Luk13g/ABM_DataGlove/Imagens/Img_02.jpg

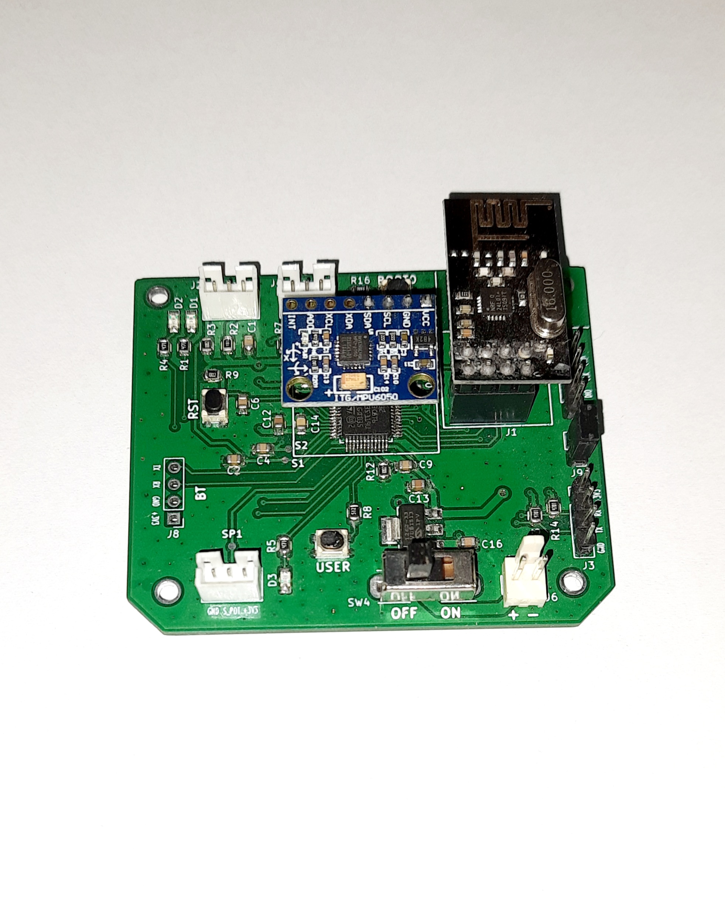
Imagens/Img_02.jpg
