Luk13g/ABM_DataGlove/Imagens/Img_01.jpg

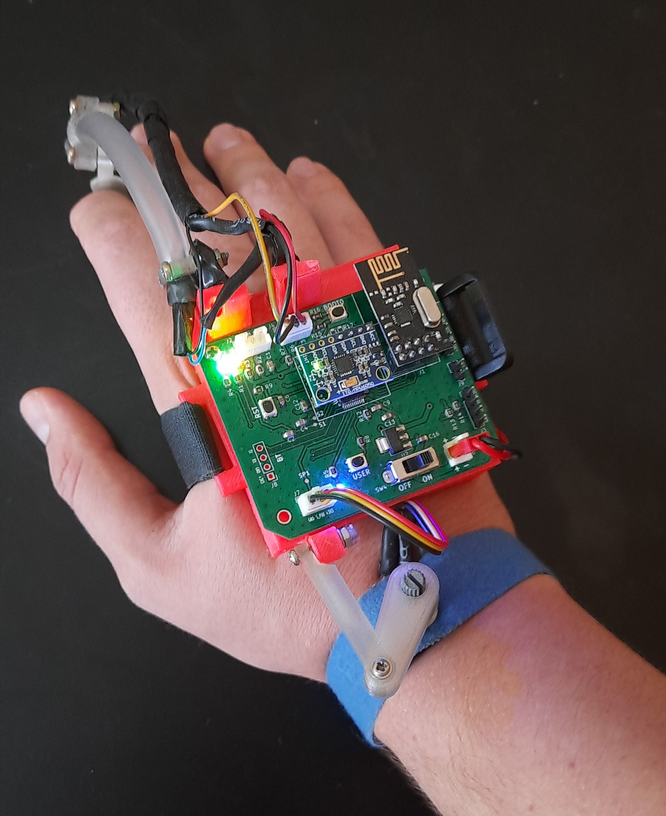
Imagens/Img_01.jpg
