Luk13g/ABM_DataGlove/README.md

# ABM_DataGlove
Data Glove for robotic hand-forearm teleoperation systems applications
