Luk13g/ABM_DataGlove/3d_parts/full_model.3mf

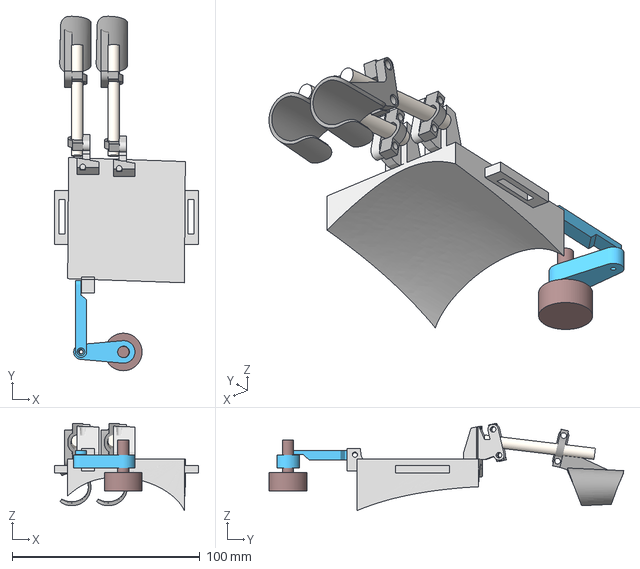
[picture p3: CAD file, 2022-12-28]
3d_parts/full_model.3mf
76.7 x 188.8 x 46.5 mm
