Luk13g/ABM_DataGlove/3d_parts/bracelet_fixation_potentiometer.stl

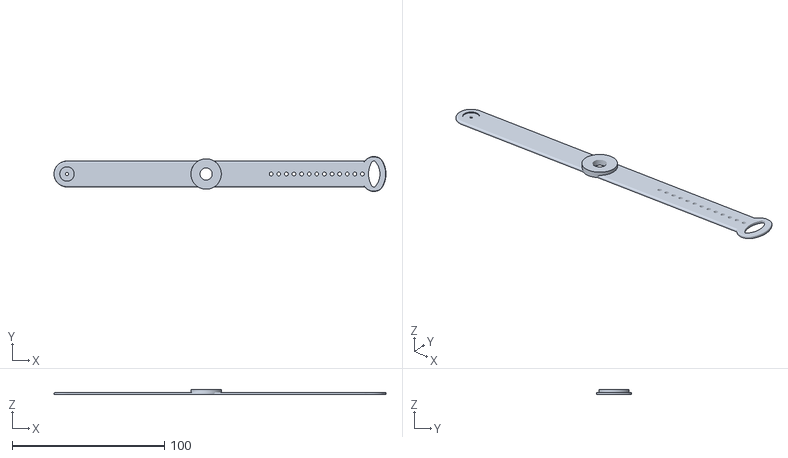
[picture p4: CAD file, 2022-12-28]
3d_parts/bracelet_fixation_potentiometer.stl
218.3 x 23.0 x 3.50
