Luk13g/ABM_DataGlove/3d_parts/base.stl

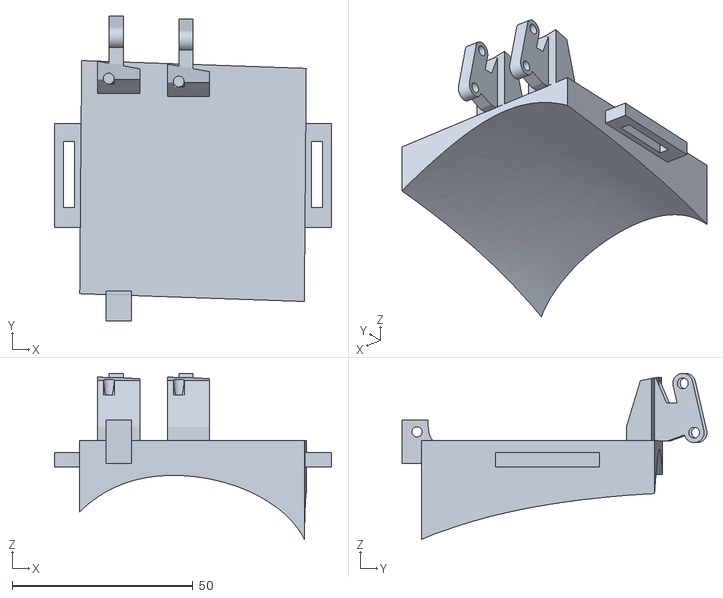
[picture p5: CAD file, 2022-12-28]
3d_parts/base.stl
76.7 x 84.4 x 46.0
