Luk13g/ABM_DataGlove/3d_parts/handle_support_finger_sensor.stl

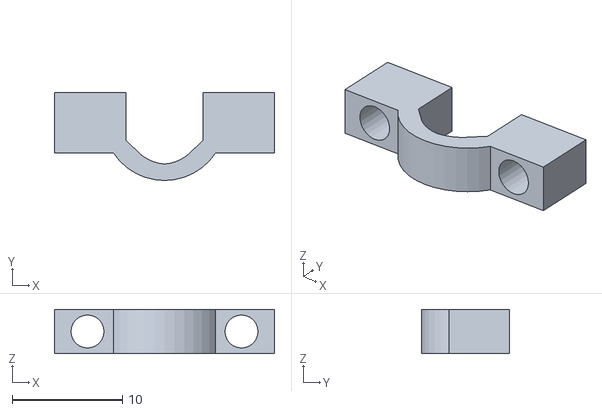
[picture p6: CAD file, 2022-12-28]
3d_parts/handle_support_finger_sensor.stl
20.0 x 8.00 x 4.00
