Luk13g/ABM_DataGlove/3d_parts/base_potentiometer.stl

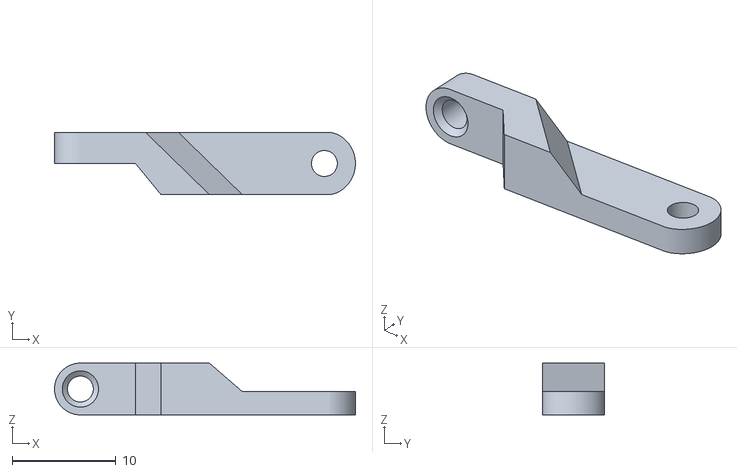
[picture p7: CAD file, 2022-12-28]
3d_parts/base_potentiometer.stl
29.0 x 6.00 x 5.00
