Luk13g/ABM_DataGlove/3d_parts/finger_suport.stl

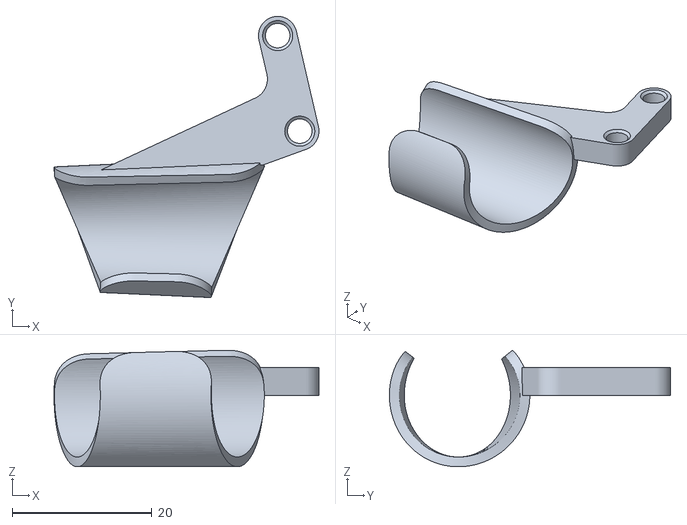
[picture p8: CAD file, 2022-12-28]
3d_parts/finger_suport.stl
37.9 x 40.2 x 16.7
