Luk13g/ABM_DataGlove/3d_parts/potentiometer_part.stl

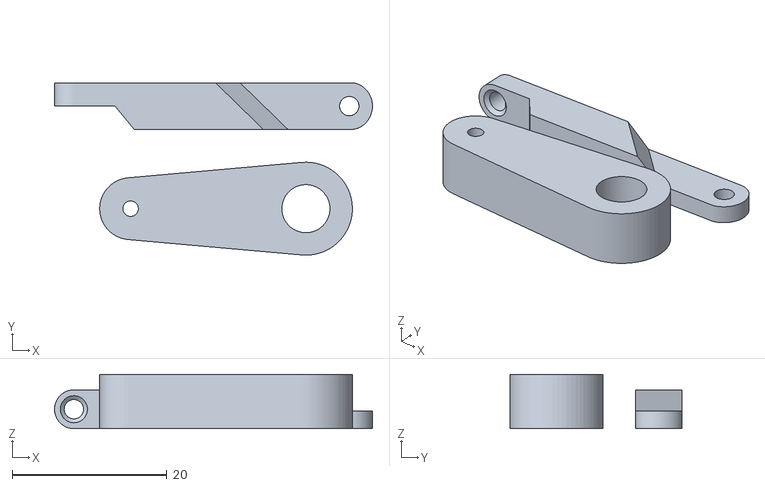
[picture p9: CAD file, 2022-12-28]
3d_parts/potentiometer_part.stl
41.0 x 22.2 x 7.00
