Luk13g/ABM_DataGlove/Hardware/v1.0/arm_control_PCB.kicad_pcb

## KiCad design Hardware/v1.0/arm_control_PCB.kicad_pcb (2022-12-28)

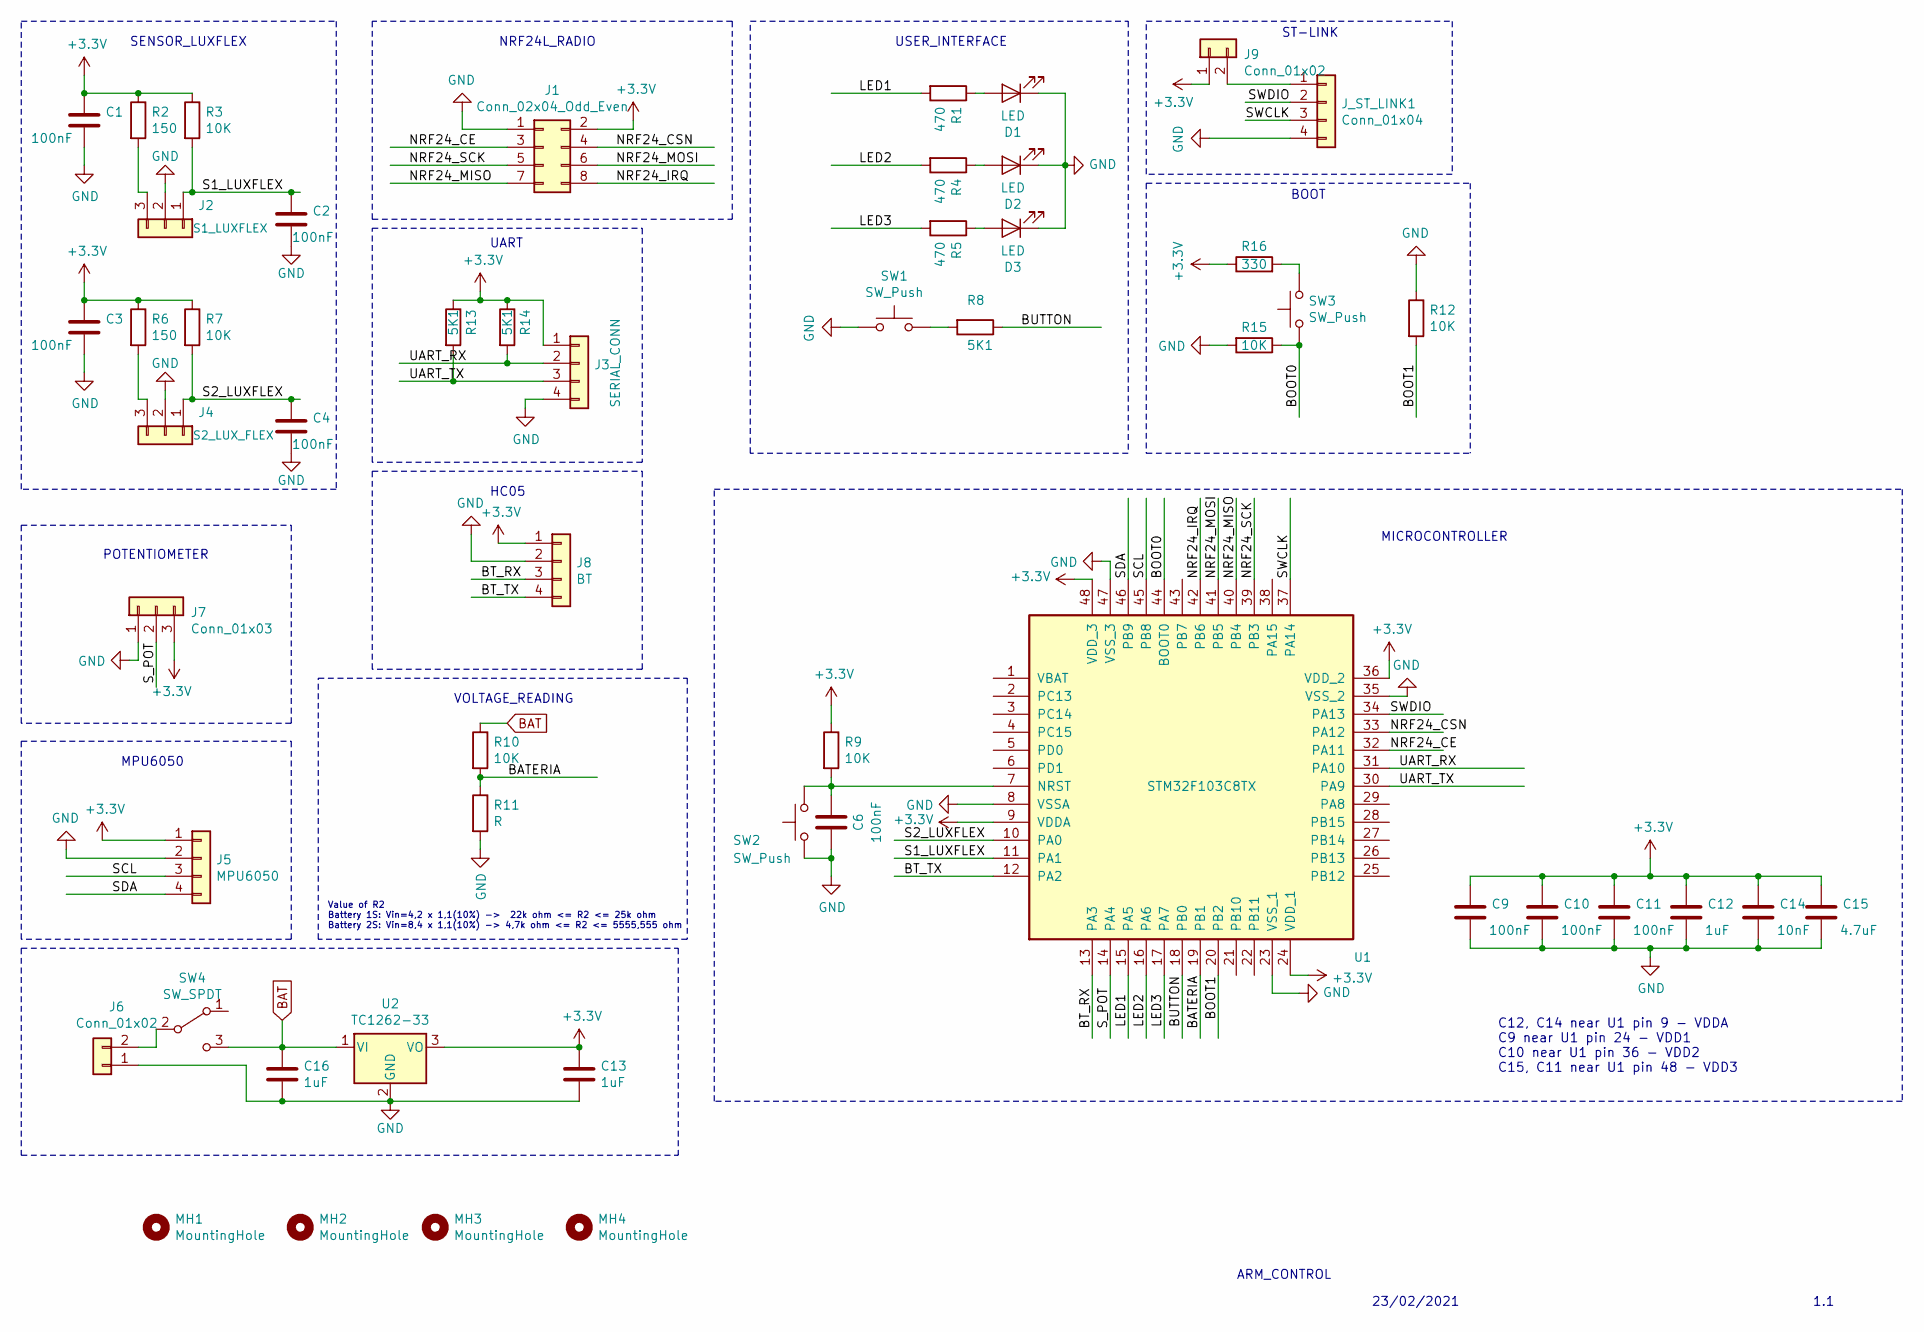
[picture p10: schematic arm_control_PCB.sch, ARM_Control]

Parts:
C1, C2, C3, C4, C6, C9, C10, C11: 100nF; C_0805
C12, C13: 1uF; C_0805
C14: 10nF; C_0805
C15: 4.7uF; C_0805
C16: 1uF; C_0805_2012Metric
D1, D2, D3: LED; LED_0805
J1: Conn_02x04_Odd_Even; Socket_Strip_Straight_2x04_Pitch2.54mm
J2: S1_LUXFLEX; JST_PH_B3B-PH-K_03x2.00mm_Straight
J3: SERIAL_CONN; Socket_Strip_Straight_1x04_Pitch2.54mm
J4: S2_LUX_FLEX; JST_PH_B3B-PH-K_03x2.00mm_Straight
J5: MPU6050; Socket_Strip_Straight_1x04_Pitch2.54mm
J6, J9: Conn_01x02; Pin_Header_Straight_1x02_Pitch2.54mm
J7: Conn_01x03; JST_PH_B3B-PH-K_03x2.00mm_Straight
J8: BT; Socket_Strip_Straight_1x04_Pitch2.54mm
J_ST_LINK1: Conn_01x04; Pin_Header_Straight_1x04_Pitch2.54mm
MH1, MH2, MH3, MH4: MountingHole; SolderWirePad_single_1-2mmDrill
R1, R4, R5: 470; R_0805
R2, R6: 150; R_0805
R3, R7, R9, R10, R12, R15: 10K; R_0805
R8, R13, R14: 5K1; R_0805
R11: R; R_0805
R16: 330; R_0805
SW1, SW2, SW3: SW_Push; SW_SPST_PTS810
SW4: SW_SPDT; SW_SS12F23G6_Angled
U1: STM32F103C8TX; LQFP-48_7x7mm_Pitch0.5mm
U2: TC1262-33; SOT-223-3_TabPin2

Connections:
+3V3: C1.1, C3.1, C9.1, C10.1, C11.1, C12.1, C13.1, C14.1, C15.1, J1.2, J3.1, J5.1, J7.3, J8.1, J9.1, R2.1, R3.1, R6.1, R7.1, R9.1, R13.1, R14.1, R16.1, U1.9 (VDDA), U1.24 (VDD_1), U1.36 (VDD_2), U1.48 (VDD_3), U2.3 (VO)
/BATERIA: R10.2, R11.1, U1.19 (PB1)
/BOOT0: R15.1, SW3.1, U1.44 (BOOT0); also elsewhere on the board
/BOOT1: R12.2, U1.20 (PB2)
/BT_RX: J8.3, U1.13 (PA3)
/BT_TX: J8.4, U1.12 (PA2)
/BUTTON: R8.1, U1.18 (PB0)
/LED1: R1.2, U1.15 (PA5)
/LED2: R4.2, U1.16 (PA6)
/LED3: R5.2, U1.17 (PA7)
/NRF24_CE: J1.3, U1.32 (PA11)
/NRF24_CSN: J1.4, U1.33 (PA12)
/NRF24_IRQ: J1.8, U1.42 (PB6)
/NRF24_MISO: J1.7, U1.40 (PB4)
/NRF24_MOSI: J1.6, U1.41 (PB5)
/NRF24_SCK: J1.5, U1.39 (PB3)
/S1_LUXFLEX: C2.1, J2.1, R3.2, U1.11 (PA1)
/S2_LUXFLEX: C4.1, J4.1, R7.2, U1.10 (PA0)
/SCL: J5.3, U1.45 (PB8)
/SDA: J5.4, U1.46 (PB9)
/SWCLK: J_ST_LINK1.3, U1.37 (PA14); also elsewhere on the board
/SWDIO: J_ST_LINK1.2, U1.34 (PA13); also elsewhere on the board
/S_POT: J7.2, U1.14 (PA4)
/UART_RX: J3.2, R14.2, U1.31 (PA10)
/UART_TX: J3.3, R13.2, U1.30 (PA9)
BAT: C16.1, R10.1, SW4.3 (C), U2.1 (VI)
GND: C1.2, C2.2, C3.2, C4.2, C6.2, C9.2, C10.2, C11.2, C12.2, C13.2, C14.2, C15.2, C16.2, D1.1 (K), D2.1 (K), D3.1 (K), J1.1, J2.2, J3.4, J4.2, J5.2, J6.1, J7.1, J8.2, J_ST_LINK1.4, R11.2, R12.1, R15.2, SW1.1, SW2.1, U1.8 (VSSA), U1.23 (VSS_1), U1.35 (VSS_2), U1.47 (VSS_3), U2.2 (GND); also elsewhere on the board
unnamed 27: C6.1, R9.2, SW2.2, U1.7 (NRST); also elsewhere on the board
unnamed: D1.2 (A), R1.1
unnamed: D2.2 (A), R4.1
unnamed: D3.2 (A), R5.1
unnamed: J2.3, R2.2
unnamed: J4.3, R6.2
unnamed: J6.2, SW4.2 (B)
unnamed 34: J9.2, J_ST_LINK1.1; also elsewhere on the board
unnamed 35: R8.2, SW1.2; also elsewhere on the board
unnamed 36: R16.2, SW3.2; also elsewhere on the board

Notes on the sheet:
MPU6050
UART
NRF24L_RADIO
SENSOR_LUXFLEX
USER_INTERFACE
POTENTIOMETER
HC05
VOLTAGE_READING
ST-LINK
MICROCONTROLLER
C12, C14 near U1 pin 9 - VDDA C9 near U1 pin 24 - VDD1 C10 near U1 pin 36 - VDD2 C15, C11 near U1 pin 48 - VDD3
BOOT
Value of R2 Battery 1S: Vin=4,2 x 1,1(10%) -> 22k ohm <= R2 <= 25k ohm Battery 2S: Vin=8,4 x 1,1(10%) -> 4,7k ohm <= R2 <= 5555,555 ohm
ARM_CONTROL
23/02/2021
1.1

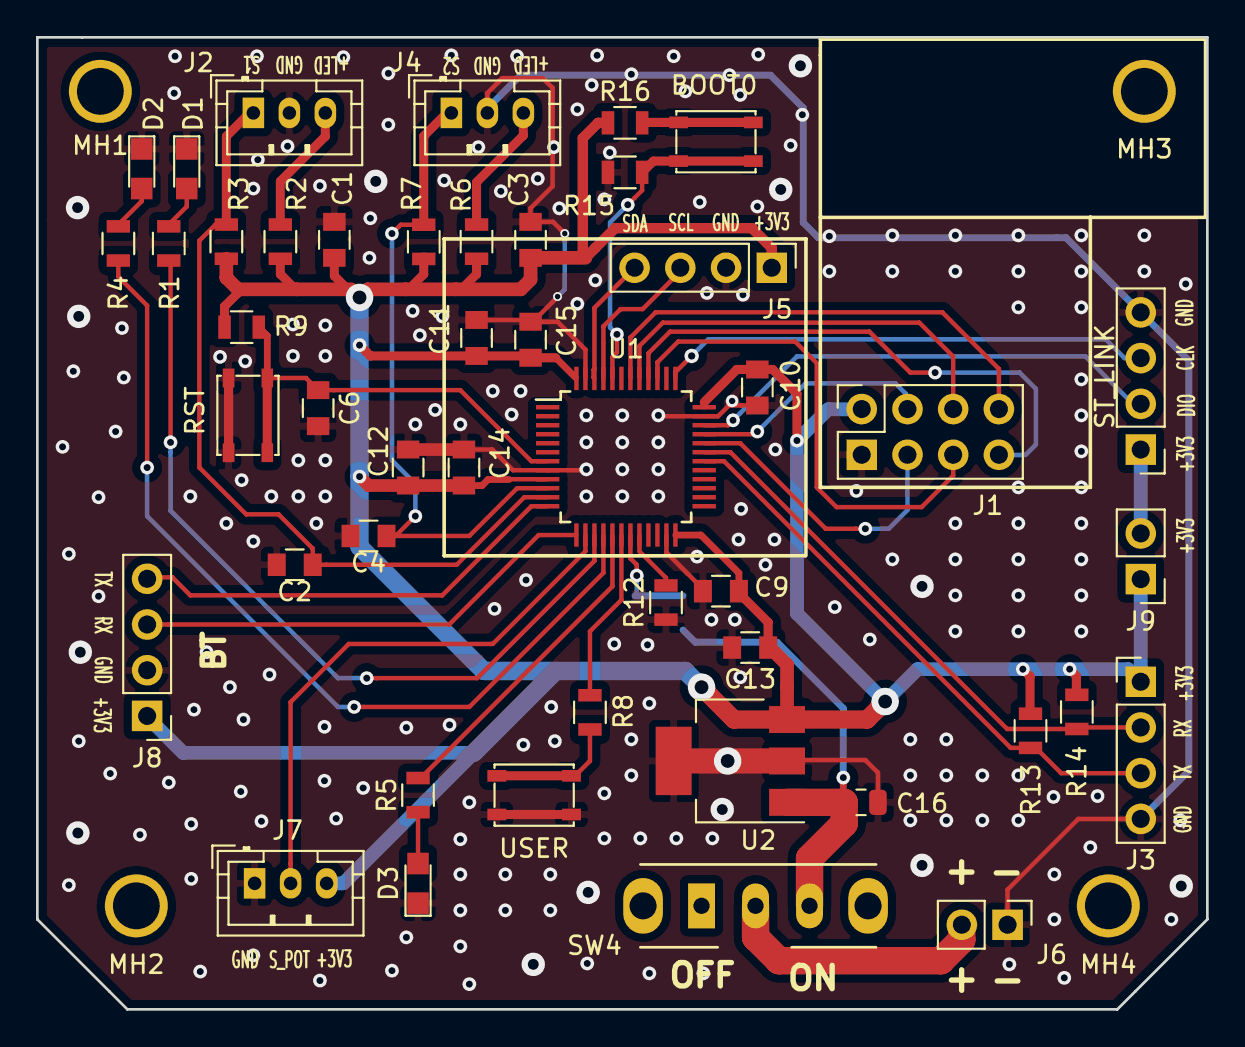
[picture p11: board arm_control_PCB.kicad_pcb from above]

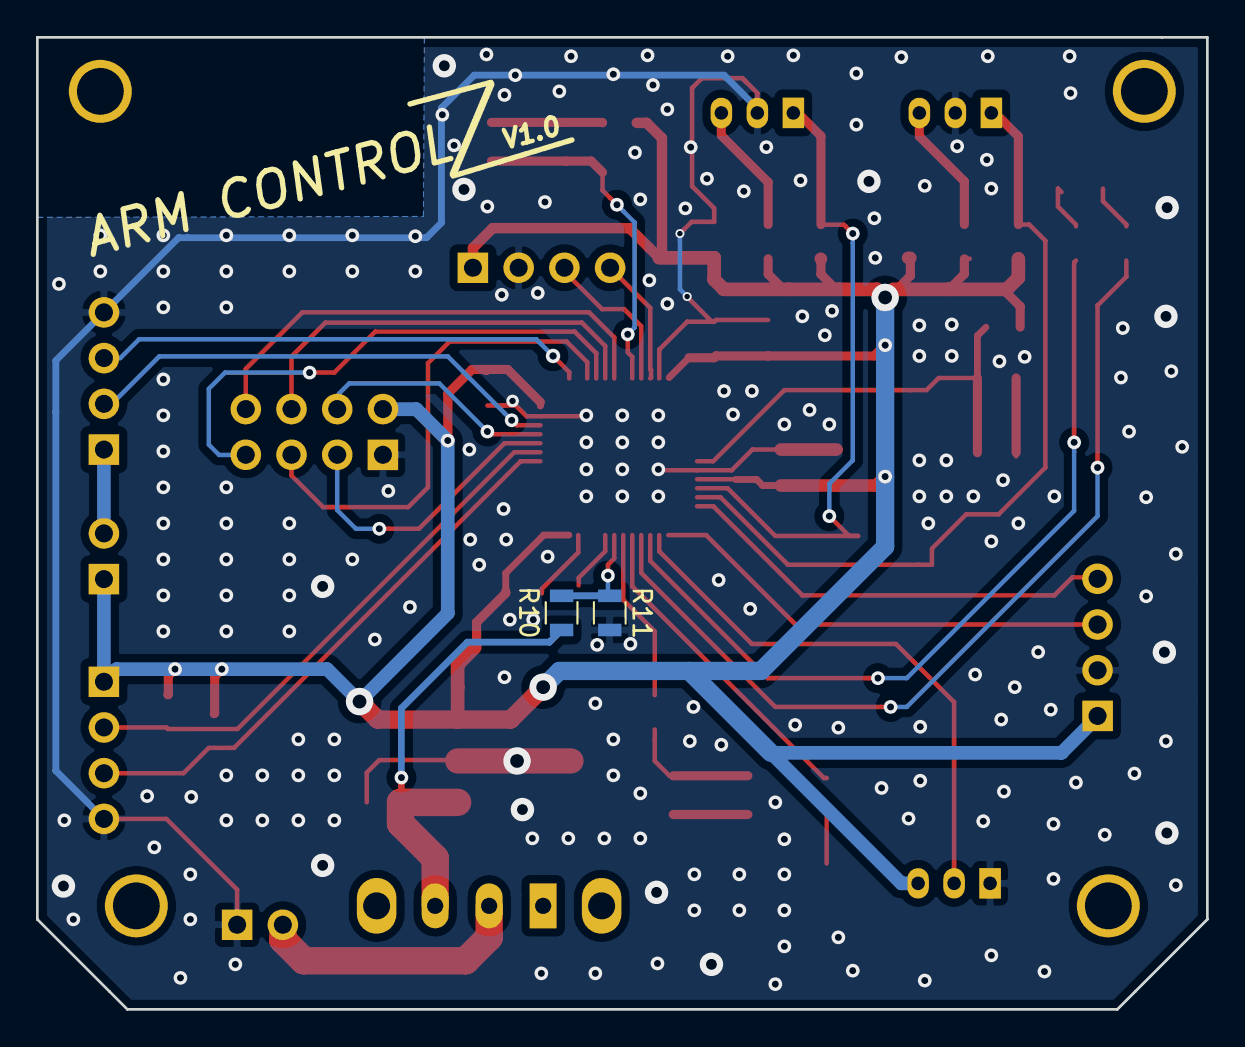
[picture p12: board arm_control_PCB.kicad_pcb from below]

Board: 2 copper layers, 65.0 x 54.0 mm, 52 parts (2 on the bottom side), 37 nets.

Other parts of the board:
BOOT0: SW_Push; SW_SPST_PTS810
RST: SW_Push; SW_SPST_PTS810
ST_LINK: Conn_01x04; Pin_Header_Straight_1x04_Pitch2.54mm
USER: SW_Push; SW_SPST_PTS810

Their connections:
/BOOT0: BOOT0.1; also elsewhere on the board
/SWCLK: ST_LINK.3; also elsewhere on the board
/SWDIO: ST_LINK.2; also elsewhere on the board
GND: RST.1, ST_LINK.4, USER.1; also elsewhere on the board
unnamed 27: RST.2; also elsewhere on the board
unnamed 34: ST_LINK.1; also elsewhere on the board
unnamed 35: USER.2; also elsewhere on the board
unnamed 36: BOOT0.2; also elsewhere on the board
