Luk13g/ABM_DataGlove/Firmware/ARM_CONTROL_RF_V2/ARM_CONTROL_RF_V2.ioc

Mcu.UserName=STM32F103C8Tx
PA0-WKUP.Signal=ADCx_IN0
PA10.Signal=USART1_RX
PA11.GPIO_Label=RF_CE
PA11.Signal=GPIO_Output
PA12.GPIO_Label=RF_CSN
PA12.Signal=GPIO_Output
PA13.Signal=SYS_JTMS-SWDIO
PA14.Signal=SYS_JTCK-SWCLK
PA3.GPIO_Label=KEY_SELECT
PA3.Signal=GPIO_Input
PA4.Signal=ADCx_IN4
PA5.GPIO_Label=LED1
PA5.Signal=GPIO_Output
PA6.GPIO_Label=LED2
PA6.Signal=GPIO_Output
PA7.GPIO_Label=LED3
PA7.Signal=GPIO_Output
PA9.Signal=USART1_TX
PB0.GPIO_Label=SW_INT
PB0.Signal=GPXTI0
PB13.Signal=SPI2_SCK
PB14.Signal=SPI2_MISO
PB15.Signal=SPI2_MOSI
PB3.GPIO_Label=RF_IRQ
PB3.Signal=GPXTI3
PB6.Signal=I2C1_SCL
PB7.Signal=I2C1_SDA
