Luk13g/ABM_DataGlove/Firmware/ARM_CONTROL_RF_V2/Core/Inc/main.h

#define KEY_SELECT_Pin GPIO_PIN_3
#define KEY_SELECT_GPIO_Port GPIOA
#define LED1_Pin GPIO_PIN_5
#define LED1_GPIO_Port GPIOA
#define LED2_Pin GPIO_PIN_6
#define LED2_GPIO_Port GPIOA
#define LED3_Pin GPIO_PIN_7
#define LED3_GPIO_Port GPIOA
#define SW_INT_Pin GPIO_PIN_0
#define SW_INT_GPIO_Port GPIOB
#define SW_INT_EXTI_IRQn EXTI0_IRQn
#define RF_CE_Pin GPIO_PIN_11
#define RF_CE_GPIO_Port GPIOA
#define RF_CSN_Pin GPIO_PIN_12
#define RF_CSN_GPIO_Port GPIOA
#define RF_IRQ_Pin GPIO_PIN_3
#define RF_IRQ_GPIO_Port GPIOB
#define RF_IRQ_EXTI_IRQn EXTI3_IRQn
