Luk13g/ABM_DataGlove/Firmware/ARM_CONTROL_RF_V2/Core/Src/nrf24.c

// Functions to manage the nRF24L01+ transceiver
#include <stdint.h>
#include <stdbool.h>
#include "hw.h"
#include "nrf24.h"
#include "nrf24_app.h"


// Read a register
// input:
//   reg - number of register to read
// return: value of register
static uint8_t nRF24_ReadReg(uint8_t reg) {
	uint8_t value;

	hw_nrf24_csn_low();
	hw_nrf24_spi_rw(reg & nRF24_MASK_REG_MAP);
	value = hw_nrf24_spi_rw(nRF24_CMD_NOP);
	hw_nrf24_csn_high();

	return value;
}

// Write a new value to register
// input:
//   reg - number of register to write
//   value - value to write
static void nRF24_WriteReg(uint8_t reg, uint8_t value) {
	hw_nrf24_csn_low();
	if (reg < nRF24_CMD_W_REGISTER) {
		// This is a register access
		hw_nrf24_spi_rw(nRF24_CMD_W_REGISTER | (reg & nRF24_MASK_REG_MAP));
		hw_nrf24_spi_rw(value);
	} else {
		// This is a single byte command or future command/register
		hw_nrf24_spi_rw(reg);
		if ((reg != nRF24_CMD_FLUSH_TX) && (reg != nRF24_CMD_FLUSH_RX) && \
				(reg != nRF24_CMD_REUSE_TX_PL) && (reg != nRF24_CMD_NOP)) {
			// Send register value
			hw_nrf24_spi_rw(value);
		}
	}
	hw_nrf24_csn_high();
}

// Read a multi-byte register
// input:
//   reg - number of register to read
//   pBuf - pointer to the buffer for register data
//   count - number of bytes to read
static void nRF24_ReadMBReg(uint8_t reg, uint8_t *pBuf, uint8_t count) {
	hw_nrf24_csn_low();
	hw_nrf24_spi_rw(reg);
	while (count--) {
		*pBuf++ = hw_nrf24_spi_rw(nRF24_CMD_NOP);
	}
	hw_nrf24_csn_high();
}

// Write a multi-byte register
// input:
//   reg - number of register to write
//   pBuf - pointer to the buffer with data to write
//   count - number of bytes to write
static void nRF24_WriteMBReg(uint8_t reg, uint8_t *pBuf, uint8_t count) {
	hw_nrf24_csn_low();
	hw_nrf24_spi_rw(reg);
	while (count--) {
		hw_nrf24_spi_rw(*pBuf++);
	}
	hw_nrf24_csn_high();
}

// Set transceiver to it's initial state
// note: RX/TX pipe addresses remains untouched
void nRF24_Init(void) {
	// Write to registers their initial values

	nRF24_WriteReg(nRF24_REG_CONFIG, 0x08);
	nRF24_WriteReg(nRF24_REG_EN_AA, 0x3F);
	nRF24_WriteReg(nRF24_REG_EN_RXADDR, 0x03);
	nRF24_WriteReg(nRF24_REG_SETUP_AW, 0x03);
	nRF24_WriteReg(nRF24_REG_SETUP_RETR, 0x03);
	nRF24_WriteReg(nRF24_REG_RF_CH, 0x02);
	nRF24_WriteReg(nRF24_REG_RF_SETUP, 0x0E);
	nRF24_WriteReg(nRF24_REG_STATUS, 0x00);
	nRF24_WriteReg(nRF24_REG_RX_PW_P0, 0x00);
	nRF24_WriteReg(nRF24_REG_RX_PW_P1, 0x00);
	nRF24_WriteReg(nRF24_REG_RX_PW_P2, 0x00);
	nRF24_WriteReg(nRF24_REG_RX_PW_P3, 0x00);
	nRF24_WriteReg(nRF24_REG_RX_PW_P4, 0x00);
	nRF24_WriteReg(nRF24_REG_RX_PW_P5, 0x00);

	// enable advanced features
	nRF24_WriteReg(nRF24_CMD_ACTIVATE, 0x73);
	nRF24_WriteReg(nRF24_REG_DYNPD, 0x3F);
	nRF24_WriteReg(nRF24_REG_FEATURE, 0x00);

	// Clear the FIFO's
	nRF24_FlushRX();
	nRF24_FlushTX();

	// Clear any pending interrupt flags
	nRF24_ClearIRQFlags();

	// Deassert CSN pin (chip release)
	hw_nrf24_csn_high();
}

// Check if the nRF24L01 present
// return:
//   1 - nRF24L01 is online and responding
//   0 - received sequence differs from original
uint8_t nRF24_Check(void) {
	uint8_t rxbuf[5] = { 0 };
	uint8_t i;
	uint8_t *ptr = (uint8_t *)nRF24_TEST_ADDR;

	// Write test TX address and read TX_ADDR register
	nRF24_WriteMBReg(nRF24_CMD_W_REGISTER | nRF24_REG_TX_ADDR, ptr, 5);
	nRF24_ReadMBReg(nRF24_CMD_R_REGISTER | nRF24_REG_TX_ADDR, rxbuf, 5);

	// Compare buffers, return error on first mismatch
	for (i = 0; i < 5; i++) {
		if (rxbuf[i] != *ptr++) return 0;
	}

	return 1;
}

// Control transceiver power mode
// input:
//   mode - new state of power mode, one of nRF24_PWR_xx values
void nRF24_SetPowerMode(uint8_t mode) {
	uint8_t reg;

	reg = nRF24_ReadReg(nRF24_REG_CONFIG);
	if (mode == nRF24_PWR_UP) {
		// Set the PWR_UP bit of CONFIG register to wake the transceiver
		// It goes into Stanby-I mode with consumption about 26uA
		reg |= nRF24_CONFIG_PWR_UP;
	} else {
		// Clear the PWR_UP bit of CONFIG register to put the transceiver
		// into power down mode with consumption about 900nA
		reg &= ~nRF24_CONFIG_PWR_UP;
	}
	nRF24_WriteReg(nRF24_REG_CONFIG, reg);
}

// Set transceiver operational mode
// input:
//   mode - operational mode, one of nRF24_MODE_xx values
void nRF24_SetOperationalMode(uint8_t mode) {
	uint8_t reg;

	// Configure PRIM_RX bit of the CONFIG register
	reg  = nRF24_ReadReg(nRF24_REG_CONFIG);
	reg &= ~nRF24_CONFIG_PRIM_RX;
	reg |= (mode & nRF24_CONFIG_PRIM_RX);
	nRF24_WriteReg(nRF24_REG_CONFIG, reg);
}

// Configure transceiver CRC scheme
// input:
//   scheme - CRC scheme, one of nRF24_CRC_xx values
// note: transceiver will forcibly turn on the CRC in case if auto acknowledgment
//       enabled for at least one RX pipe
void nRF24_SetCRCScheme(uint8_t scheme) {
	uint8_t reg;

	// Configure EN_CRC[3] and CRCO[2] bits of the CONFIG register
	reg  = nRF24_ReadReg(nRF24_REG_CONFIG);
	reg &= ~nRF24_MASK_CRC;
	reg |= (scheme | nRF24_MASK_CRC);
	nRF24_WriteReg(nRF24_REG_CONFIG, reg);
}

// Set frequency channel
// input:
//   channel - radio frequency channel, value from 0 to 127
// note: frequency will be (2400 + channel)MHz
// note: PLOS_CNT[7:4] bits of the OBSERVER_TX register will be reset
void nRF24_SetRFChannel(uint8_t channel) {
	nRF24_WriteReg(nRF24_REG_RF_CH, channel);
}

// Set automatic retransmission parameters
// input:
//   ard - auto retransmit delay, one of nRF24_ARD_xx values
//   arc - count of auto retransmits, value form 0 to 15
// note: zero arc value means that the automatic retransmission disabled
void nRF24_SetAutoRetr(uint8_t ard, uint8_t arc) {
	// Set auto retransmit settings (SETUP_RETR register)
	nRF24_WriteReg(nRF24_REG_SETUP_RETR, (uint8_t)((ard << 4) | (arc & nRF24_MASK_RETR_ARC)));
}

// Set of address widths
// input:
//   addr_width - RX/TX address field width, value from 3 to 5
// note: this setting is common for all pipes
void nRF24_SetAddrWidth(uint8_t addr_width) {
	nRF24_WriteReg(nRF24_REG_SETUP_AW, addr_width - 2);
}

// Set static RX address for a specified pipe
// input:
//   pipe - pipe to configure address, one of nRF24_PIPEx values
//   addr - pointer to the buffer with address
// note: pipe can be a number from 0 to 5 (RX pipes) and 6 (TX pipe)
// note: buffer length must be equal to current address width of transceiver
// note: for pipes[2..5] only first byte of address will be written because
//       other bytes of address equals to pipe1
// note: for pipes[2..5] only first byte of address will be written because
//       pipes 1-5 share the four most significant address bytes
void nRF24_SetAddr(uint8_t pipe, const uint8_t *addr) {
	uint8_t addr_width;

	// RX_ADDR_Px register
	switch (pipe) {
		case nRF24_PIPETX:
		case nRF24_PIPE0:
		case nRF24_PIPE1:
			// Get address width
			addr_width = nRF24_ReadReg(nRF24_REG_SETUP_AW) + 1;
			// Write address in reverse order (LSByte first)
			addr += addr_width;
			hw_nrf24_csn_low();
			hw_nrf24_spi_rw(nRF24_CMD_W_REGISTER | nRF24_ADDR_REGS[pipe]);
			do {
				hw_nrf24_spi_rw(*addr--);
			} while (addr_width--);
			hw_nrf24_csn_high();
			break;
		case nRF24_PIPE2:
		case nRF24_PIPE3:
		case nRF24_PIPE4:
		case nRF24_PIPE5:
			// Write address LSBbyte (only first byte from the addr buffer)
			nRF24_WriteReg(nRF24_ADDR_REGS[pipe], *addr);
			break;
		default:
			// Incorrect pipe number -> do nothing
			break;
	}
}

// Configure RF output power in TX mode
// input:
//   tx_pwr - RF output power, one of nRF24_TXPWR_xx values
void nRF24_SetTXPower(uint8_t tx_pwr) {
	uint8_t reg;

	// Configure RF_PWR[2:1] bits of the RF_SETUP register
	reg  = nRF24_ReadReg(nRF24_REG_RF_SETUP);
	reg &= ~nRF24_MASK_RF_PWR;
	reg |= tx_pwr;
	nRF24_WriteReg(nRF24_REG_RF_SETUP, reg);
}

// Configure transceiver data rate
// input:
//   data_rate - data rate, one of nRF24_DR_xx values
void nRF24_SetDataRate(uint8_t data_rate) {
	uint8_t reg;

	// Configure RF_DR_LOW[5] and RF_DR_HIGH[3] bits of the RF_SETUP register
	reg  = nRF24_ReadReg(nRF24_REG_RF_SETUP);
	reg &= ~nRF24_MASK_DATARATE;
	reg |= data_rate;
	nRF24_WriteReg(nRF24_REG_RF_SETUP, reg);
}

// Configure a specified RX pipe
// input:
//   pipe - number of the RX pipe, value from 0 to 5
//   aa_state - state of auto acknowledgment, one of nRF24_AA_xx values
//   payload_len - payload length in bytes
void nRF24_SetRXPipe(uint8_t pipe, uint8_t aa_state, uint8_t payload_len) {
	uint8_t reg;

	// Enable the specified pipe (EN_RXADDR register)
	reg = (nRF24_ReadReg(nRF24_REG_EN_RXADDR) | (1 << pipe)) & nRF24_MASK_EN_RX;
	nRF24_WriteReg(nRF24_REG_EN_RXADDR, reg);

	// Set RX payload length (RX_PW_Px register)
	nRF24_WriteReg(nRF24_RX_PW_PIPE[pipe], payload_len & nRF24_MASK_RX_PW);

	// Set auto acknowledgment for a specified pipe (EN_AA register)
	reg = nRF24_ReadReg(nRF24_REG_EN_AA);
	if (aa_state == nRF24_AA_ON) {
		reg |=  (1 << pipe);
	} else {
		reg &= ~(1 << pipe);
	}
	nRF24_WriteReg(nRF24_REG_EN_AA, reg);
}

// Disable specified RX pipe
// input:
//   PIPE - number of RX pipe, value from 0 to 5
void nRF24_ClosePipe(uint8_t pipe) {
	uint8_t reg;

	reg  = nRF24_ReadReg(nRF24_REG_EN_RXADDR);
	reg &= ~(1 << pipe);
	reg &= nRF24_MASK_EN_RX;
	nRF24_WriteReg(nRF24_REG_EN_RXADDR, reg);
}

// Enable the auto retransmit (a.k.a. enhanced ShockBurst) for the specified RX pipe
// input:
//   pipe - number of the RX pipe, value from 0 to 5
void nRF24_EnableAA(uint8_t pipe) {
	uint8_t reg;

	// Set bit in EN_AA register
	reg  = nRF24_ReadReg(nRF24_REG_EN_AA);
	reg |= (1 << pipe);
	nRF24_WriteReg(nRF24_REG_EN_AA, reg);
}

// Disable the auto retransmit (a.k.a. enhanced ShockBurst) for one or all RX pipes
// input:
//   pipe - number of the RX pipe, value from 0 to 5, any other value will disable AA for all RX pipes
void nRF24_DisableAA(uint8_t pipe) {
	uint8_t reg;

	if (pipe > 5) {
		// Disable Auto-ACK for ALL pipes
		nRF24_WriteReg(nRF24_REG_EN_AA, 0x00);
	} else {
		// Clear bit in the EN_AA register
		reg  = nRF24_ReadReg(nRF24_REG_EN_AA);
		reg &= ~(1 << pipe);
		nRF24_WriteReg(nRF24_REG_EN_AA, reg);
	}
}

void nRF24_SetFeatureReg(uint8_t features)
{
	uint8_t reg = nRF24_ReadReg(nRF24_REG_FEATURE);

	reg &= ~nRF24_MASK_FEATURE_REG;
	reg |= features;

	nRF24_WriteReg(nRF24_REG_FEATURE, reg);
}

// Get value of the STATUS register
// return: value of STATUS register
uint8_t nRF24_GetStatus(void) {
	return nRF24_ReadReg(nRF24_REG_STATUS);
}

// Get pending IRQ flags
// return: current status of RX_DR, TX_DS and MAX_RT bits of the STATUS register
uint8_t nRF24_GetIRQFlags(void) {
	return (nRF24_ReadReg(nRF24_REG_STATUS) & nRF24_MASK_STATUS_IRQ);
}

// Get status of the RX FIFO
// return: one of the nRF24_STATUS_RXFIFO_xx values
uint8_t nRF24_GetStatus_RXFIFO(void) {
	return (nRF24_ReadReg(nRF24_REG_FIFO_STATUS) & nRF24_MASK_RXFIFO);
}

// Get status of the TX FIFO
// return: one of the nRF24_STATUS_TXFIFO_xx values
// note: the TX_REUSE bit ignored
uint8_t nRF24_GetStatus_TXFIFO(void) {
	return ((nRF24_ReadReg(nRF24_REG_FIFO_STATUS) & nRF24_MASK_TXFIFO) >> 4);
}

// Get pipe number for the payload available for reading from RX FIFO
// return: pipe number or 0x07 if the RX FIFO is empty
uint8_t nRF24_GetRXSource(void) {
	return ((nRF24_ReadReg(nRF24_REG_STATUS) & nRF24_MASK_RX_P_NO) >> 1);
}

// Get auto retransmit statistic
// return: value of OBSERVE_TX register which contains two counters encoded in nibbles:
//   high - lost packets count (max value 15, can be reseted by write to RF_CH register)
//   low  - retransmitted packets count (max value 15, reseted when new transmission starts)
uint8_t nRF24_GetRetransmitCounters(void) {
	return (nRF24_ReadReg(nRF24_REG_OBSERVE_TX));
}

uint8_t nRF24_GetFeatureReg(void)
{
	return nRF24_ReadReg(nRF24_REG_FEATURE);
}
// Reset packet lost counter (PLOS_CNT bits in OBSERVER_TX register)
void nRF24_ResetPLOS(void) {
	uint8_t reg;

	// The PLOS counter is reset after write to RF_CH register
	reg = nRF24_ReadReg(nRF24_REG_RF_CH);
	nRF24_WriteReg(nRF24_REG_RF_CH, reg);
}

// Flush the TX FIFO
void nRF24_FlushTX(void) {
	nRF24_WriteReg(nRF24_CMD_FLUSH_TX, nRF24_CMD_NOP);
}

// Flush the RX FIFO
void nRF24_FlushRX(void) {
	nRF24_WriteReg(nRF24_CMD_FLUSH_RX, nRF24_CMD_NOP);
}

// Clear any pending IRQ flags
void nRF24_ClearIRQFlags(void) {
	uint8_t reg;

	// Clear RX_DR, TX_DS and MAX_RT bits of the STATUS register
	reg  = nRF24_ReadReg(nRF24_REG_STATUS);
	reg |= nRF24_MASK_STATUS_IRQ;
	nRF24_WriteReg(nRF24_REG_STATUS, reg);
}

// Write TX payload
// input:
//   pBuf - pointer to the buffer with payload data
//   length - payload length in bytes
void nRF24_WritePayload(uint8_t *pBuf, uint8_t length) {
	nRF24_WriteMBReg(nRF24_CMD_W_TX_PAYLOAD, pBuf, length);
}

// Read top level payload available in the RX FIFO
// input:
//   pBuf - pointer to the buffer to store a payload data
//   length - pointer to variable to store a payload length
// return: one of nRF24_RX_xx values
//   nRF24_RX_PIPEX - packet has been received from the pipe number X
//   nRF24_RX_EMPTY - the RX FIFO is empty
nRF24_RXResult nRF24_ReadPayload(uint8_t *pBuf, uint8_t *length) {
	uint8_t pipe;

	// Extract a payload pipe number from the STATUS register
	pipe = (nRF24_ReadReg(nRF24_REG_STATUS) & nRF24_MASK_RX_P_NO) >> 1;

	// RX FIFO empty?
	if (pipe < 6) {
		// Get payload length
		*length = nRF24_ReadReg(nRF24_RX_PW_PIPE[pipe]);

		// Read a payload from the RX FIFO
		if (*length) {
			nRF24_ReadMBReg(nRF24_CMD_R_RX_PAYLOAD, pBuf, *length);
		}

		return ((nRF24_RXResult)pipe);
	}

	// The RX FIFO is empty
	*length = 0;

	return nRF24_RX_EMPTY;
}

nRF24_RXFIFO nRF24_ReadRxFifoPayload(uint8_t *pBuf, uint8_t length)
{
	// nRF24_CMD_R_RX_PL_WID does not work as expected, it is returning less bytes (only 0x0E instead 0x20)
	//length = nRF24_ReadReg(nRF24_CMD_R_RX_PL_WID);

	nRF24_ReadMBReg(nRF24_CMD_R_RX_PAYLOAD, pBuf, length);

	return nRF24_STATUS_RXFIFO_DATA;
}

// pipe must be valid (< 6) and must have data available (check befor calling)
void nRF24_ReadPipePayload(uint8_t pipe, uint8_t *pBuf, uint8_t *length)
{
	// Get payload length
	*length = nRF24_ReadReg(nRF24_RX_PW_PIPE[pipe]);

	// Read a payload from the RX FIFO
	if (*length) {
		nRF24_ReadMBReg(nRF24_CMD_R_RX_PAYLOAD, pBuf, *length);
	}
}

void nRF24_WriteAckPayload(uint8_t pipe, uint8_t *pBuf, uint8_t length) {
	nRF24_WriteMBReg(nRF24_CMD_W_ACK_PAYLOAD | (pipe & 0x07), pBuf, length);
}

void nRF24_Interrupt(void)
{
	uint8_t status;
	uint8_t fifo_status;
	uint8_t pipe;

	status = nRF24_GetStatus();
	fifo_status = nRF24_GetStatus_RXFIFO();
	pipe = (status & nRF24_MASK_RX_P_NO) >> 1;

	if(status & nRF24_FLAG_RX_DR) // data received
	{
		// 0: data; 1: empty; 2: full; 3: invalid state
		if((fifo_status != nRF24_STATUS_RXFIFO_EMPTY) && (pipe < 6))
			nrf24_app_rx_data_cbk(pipe);

		nRF24_WriteReg(nRF24_REG_STATUS, nRF24_FLAG_RX_DR);
	}

	if(status & nRF24_FLAG_TX_DS) // data sent
	{
		nRF24_WriteReg(nRF24_REG_STATUS, nRF24_FLAG_TX_DS);
		nrf24_app_tx_data_cbk(NRF24_APP_OK);
	}

	if(status & nRF24_FLAG_MAX_RT) // max RT reached
	{
		nRF24_WriteReg(nRF24_REG_STATUS, nRF24_FLAG_MAX_RT);
		nRF24_FlushTX();
		nRF24_ResetPLOS();
		nrf24_app_tx_data_cbk(NRF24_APP_TIMEOUT);
	}
}
