Luk13g/ABM_DataGlove/Firmware/ARM_CONTROL_RF_V2/Core/Inc/MPU6050.h

#ifndef MPU6050_H_
#define MPU6050_H_

#endif /* MPU6050_H_ */

#include <stdint.h>
#include <main.h>
//#include "i2c.h"
extern I2C_HandleTypeDef hi2c1;
// MPU6050 structure
typedef struct {//passar tudo para int16_t

    int16_t Accel_X_RAW;//eu usei foi esses pro bra�o
    int16_t Accel_Y_RAW;
    int16_t Accel_Z_RAW;
    double Ax;
    double Ay;
    double Az;

    int16_t Gyro_X_RAW;
    int16_t Gyro_Y_RAW;
    int16_t Gyro_Z_RAW;
    double Gx;
    double Gy;
    double Gz;

    float Temperature;

    double KalmanAngleX;
    double KalmanAngleY;
} MPU6050_t;


// Kalman structure
typedef struct {
    double Q_angle;
    double Q_bias;
    double R_measure;
    double angle;
    double bias;
    double P[2][2];
} Kalman_t;


uint8_t MPU6050_Init(I2C_HandleTypeDef *I2Cx);

void MPU6050_Read_Accel(I2C_HandleTypeDef *I2Cx, MPU6050_t *DataStruct);

void MPU6050_Read_Gyro(I2C_HandleTypeDef *I2Cx, MPU6050_t *DataStruct);

void MPU6050_Read_Temp(I2C_HandleTypeDef *I2Cx, MPU6050_t *DataStruct);

void MPU6050_Read_All(I2C_HandleTypeDef *I2Cx, MPU6050_t *DataStruct);

double Kalman_getAngle(Kalman_t *Kalman, double newAngle, double newRate, double dt);
