Luk13g/ABM_DataGlove/Firmware/ARM_CONTROL_RF_V2/Core/Inc/utility.h

/*
 * utility.h
 *
 *  Created on: Oct 31, 2020
 *      Author: lukgd
 */

#ifndef INC_UTILITY_H_
#define INC_UTILITY_H_

long map(long x, long in_min, long in_max, long out_min, long out_max);

#endif /* INC_UTILITY_H_ */
