Luk13g/ABM_DataGlove/(commit log)

2022-12-28 article containing the explanation about the developed data glove and images of the device
2022-12-28 firmware for sensor acquisition and wireless data transmission
2022-12-28 data glove 3d parts
    [base.stl, base_potentiometer.stl, finger_suport.stl, full_model.3mf, handle_support_finger_sensor.stl, potentiometer_part.stl]
2022-12-28 hardware v1.0
    [arm_control_PCB.kicad_pcb, arm_control_PCB.sch]
